patzf/DC-Motor-Board/img/rendering.png

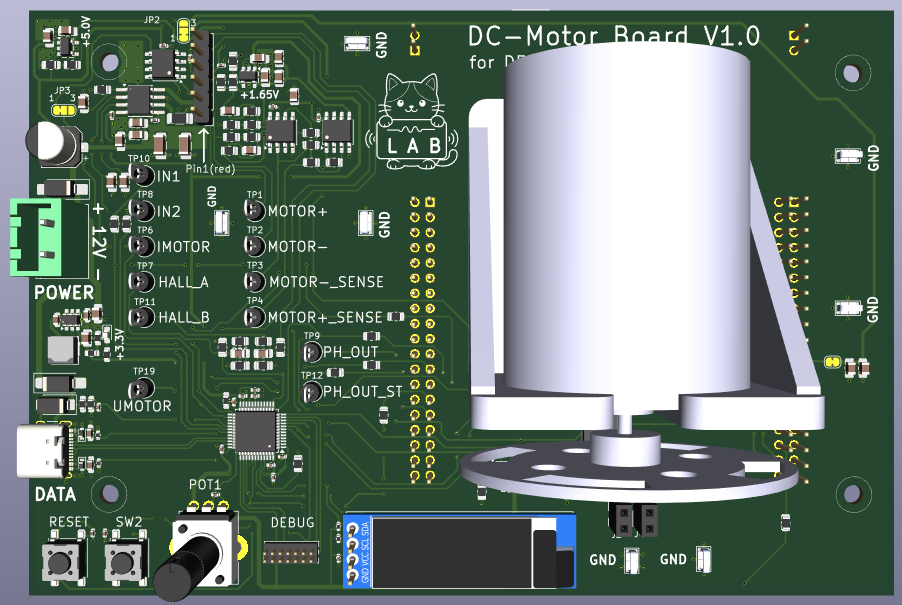
img/rendering.png
