patzf/DC-Motor-Board/fw/notes_streaming.txt

10kHz Abtastrate: Bei einem Signal: 16Bit = 2 Byte
wenn alle 10ms ein transfer zu PC: 10000*2Byte/(1000ms/10ms) = 200Byte/10ms - >8N1 -> 2kBit/10ms -> 200kBit/s 
-> ADC Buffer: doppelte Größe -> 400 Byte/ Kanal

Bei Spannung und Strom: 2 Signale zu je 16 Bit @ 10kHz: 320000 Bit/s Rohdaten ohne 16->12 "reduktion")
Für 8N1 über UART -> *1.25 weil 2 von 10 bit overhead -> 400000 Bit/s

For Standad UART:
USARTDIV = 170E6/(16*baudrate)
-> Baudrate: 460800

FOR LPUART
LPUARTDIV = 256*fck/Baudrate

For testing 1KhZ-> TIM4: prescaler (3)
170e6/((3+1)* 1e3) = 42500

ADC2_IN14: single ended rank 1: UMOTOR (diffamp output)

                         ┌─────────────────────────────┐
                         │          TIM4                │
                         │      Update Event            │
                         └──────────────┬──────────────┘
                                        │
                                        │ TRGO
                                        ▼
                         ┌─────────────────────────────┐
                         │           ADC2               │
                         │     External Trigger        │
                         │     ADC conversion          │
                         └──────────────┬──────────────┘
                                        │
                                        │ ADC result
                                        ▼
                         ┌─────────────────────────────┐
                         │        ADC2 DMA              │
                         │       Circular Mode          │
                         └──────────────┬──────────────┘
                                        │
                         ┌──────────────┴──────────────┐
                         │                             │
                         ▼                             ▼
                  Half-transfer                  Transfer-complete
                    interrupt                       interrupt
                         │                             │
                         ▼                             ▼
          HAL_ADC_ConvHalfCpltCallback()     HAL_ADC_ConvCpltCallback()
                         │                             │
                         │                             │
                         ▼                             ▼
                  ┌─────────────┐               ┌─────────────┐
                  │   HALF A    │               │   HALF B    │
                  │ ADC buffer  │               │ ADC buffer  │
                  └──────┬──────┘               └──────┬──────┘
                         │                             │
                         │                             │
                         ▼                             ▼
                  LPUART TX DMA                LPUART TX DMA
                         │                             │
                         └──────────────┬──────────────┘
                                        │
                                        ▼
                                  LPUART TX pin

adc_buffer[]
┌───────────────────────┬───────────────────────┐
│        HALF A         │        HALF B         │
│                       │                       │
│ ADC writes here       │ ADC writes here       │
│ then UART sends here  │ then UART sends here  │
└───────────────────────┴───────────────────────┘
          ↑                         ↑
          │                         │
     half callback             complete callback

ADC DMA:

        fill A             fill B             fill A
    ────────────────┬────────────────┬────────────────
                    │                │
                    ▼                ▼
                 HALF IRQ         COMPLETE IRQ
                    │                │
                    │                │
                    ▼                ▼
                UART sends A     UART sends B

yes. so we now produce 12 bit adc raw data of only one channel of the ADC with 10kHz sample rate and send every 10ms. i will paste you a zip with the pc side python code. please son´t throw away the code parts that we current do not use since we will use them later. just adapt the aquisition worker code and live graph for the current so it matches what we defined

please knock out the code that only simulated data for the curretnversion so that the plotting yould be tested
we only want to use real values from now on. still, keep the qidgets as is, even if we are now only receiving data for one plot (the current) at the moment

I'll specifically adapt:

Acquisition worker → read the STM32's raw uint16_t little-endian stream.
Current acquisition → 10 kHz, one ADC channel.
Block handling → 10 samples / 20 bytes per 10 ms.
Serial buffering → robustly handle arbitrary chunks returned by the VCP, rather than assuming each read() is exactly 20 bytes.
Live current graph → update at the appropriate rate using the received samples.
Preserve the existing infrastructure/code for the other quantities/channels and future functionality, even if currently unused.
Preserve your existing architecture and naming where practical rather than rewriting the application.

please tell me exactly (please analyse deeply, not just getting back to me after the first idea) why the following python visualizsation code that vizualizes DC motor current data (at the moment, only current data is receieved, no voltage) prints the received data fine, but as soon as the source is disconnected or stopd sending data, old ringbuffer data is plotted over and over again. please point out which part of the code does this and do all necessary modifications needed so that ebery data point is plotted only once, so no old data is plotted. the "liec" plot should not increase the time axis anymore or show delivered data when there is no new data to plot .

USB: CubeMX
Enable USB device
middleware->USB device
Class for FS IP: CDC
-> user code additions as documented in screenshot named usb_enum_wait_for.png 
to wait for device enumeration. if that is not ready before adc is ready, theusb_cdc_call throws busy since the data structure is not yet initialised
-> add code for LineCoding
