patzf/DC-Motor-Board/fw/non_eak_callback.png

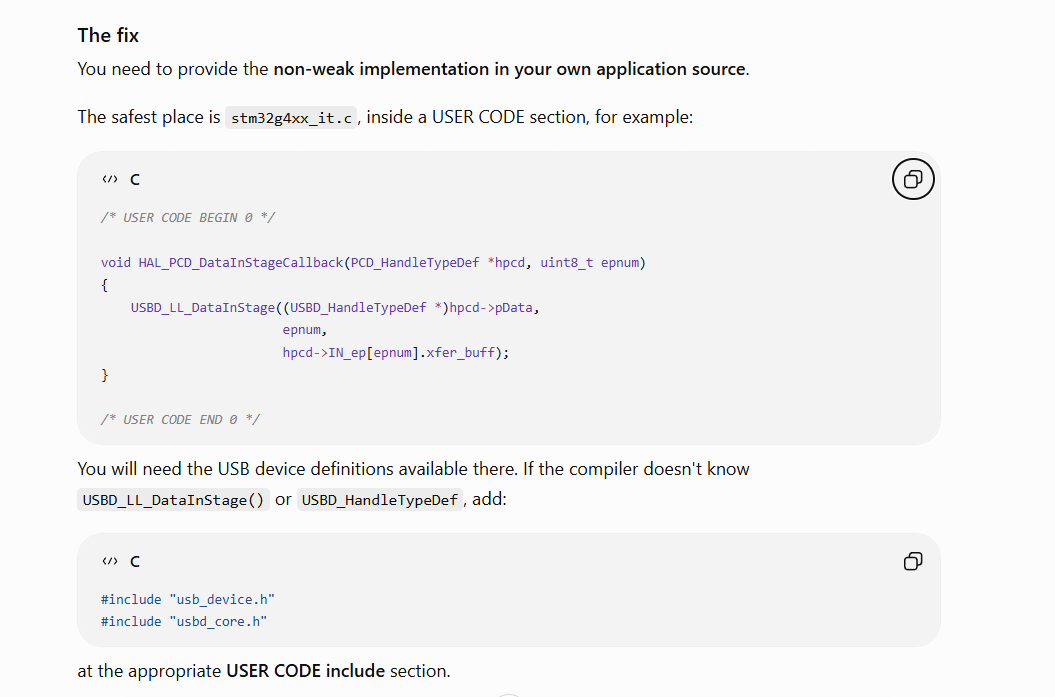
fw/non_eak_callback.png
