patzf/DC-Motor-Board/fw/Rigol_DS4014E_Captures/raw/rigol_raw_70k_20260911_002849_keine_Strombegrenzung.png

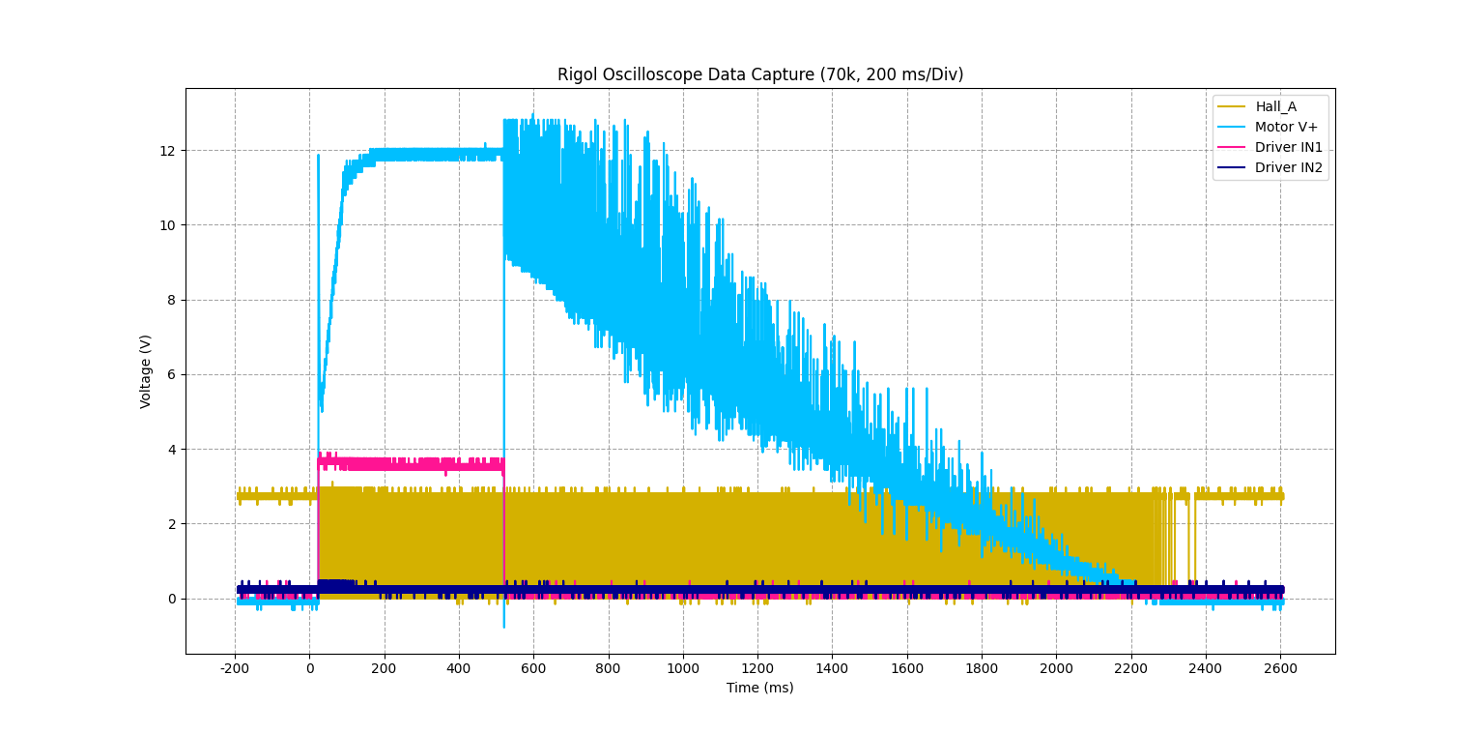
fw/Rigol_DS4014E_Captures/raw/rigol_raw_70k_20260911_002849_keine_Strombegrenzung.png
