patzf/DC-Motor-Board/fw/usb_enum_wait_for.png

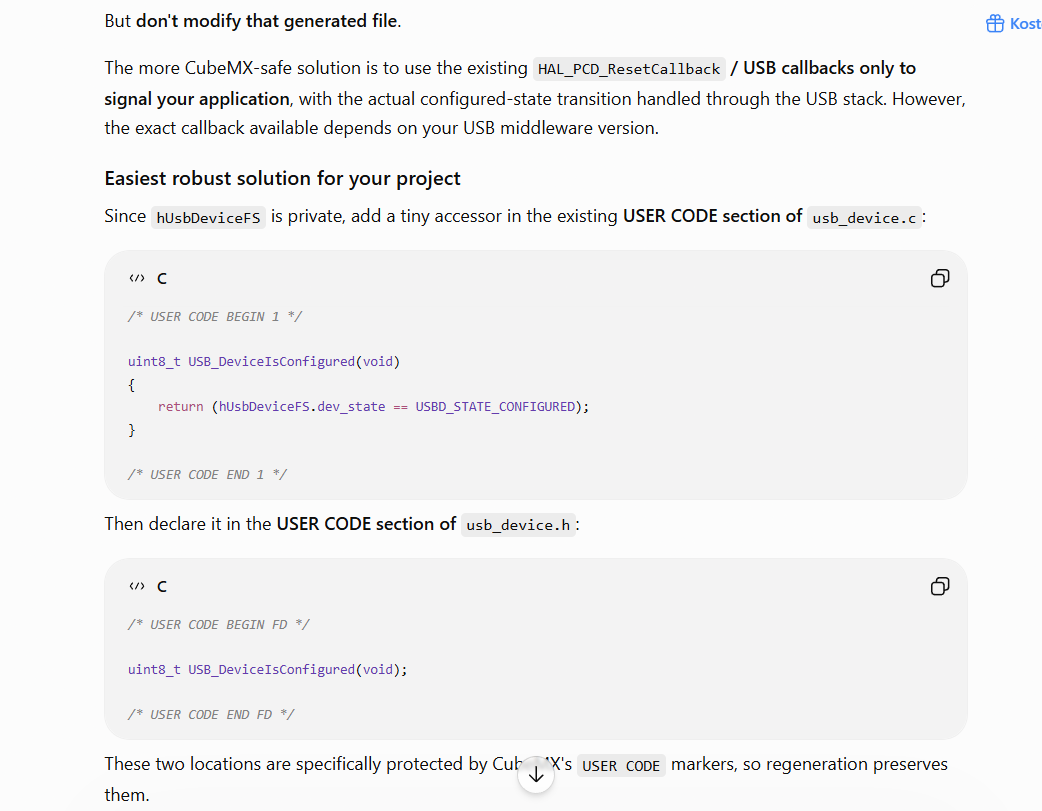
fw/usb_enum_wait_for.png
