patzf/DC-Motor-Board/img/bottom_rendering.png

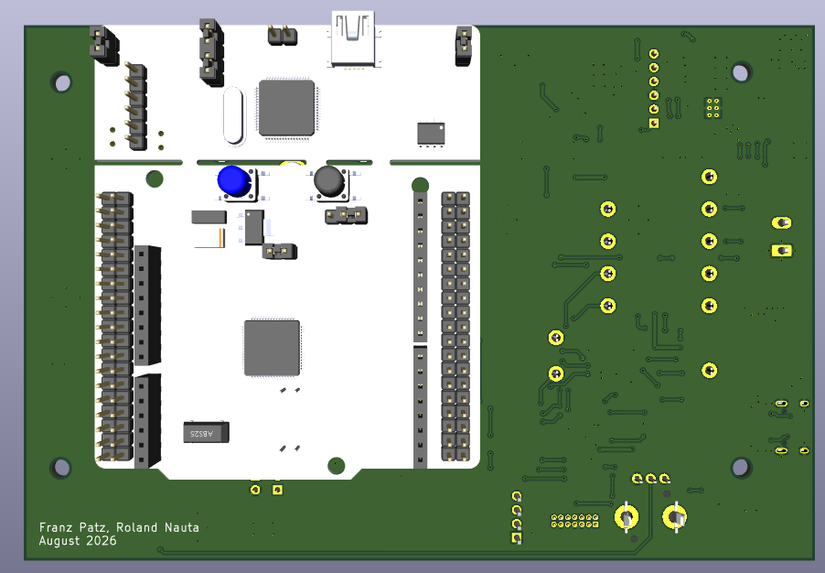
img/bottom_rendering.png
