patzf/DC-Motor-Board/hw/V1.1/NUCLEO-L432KC.step

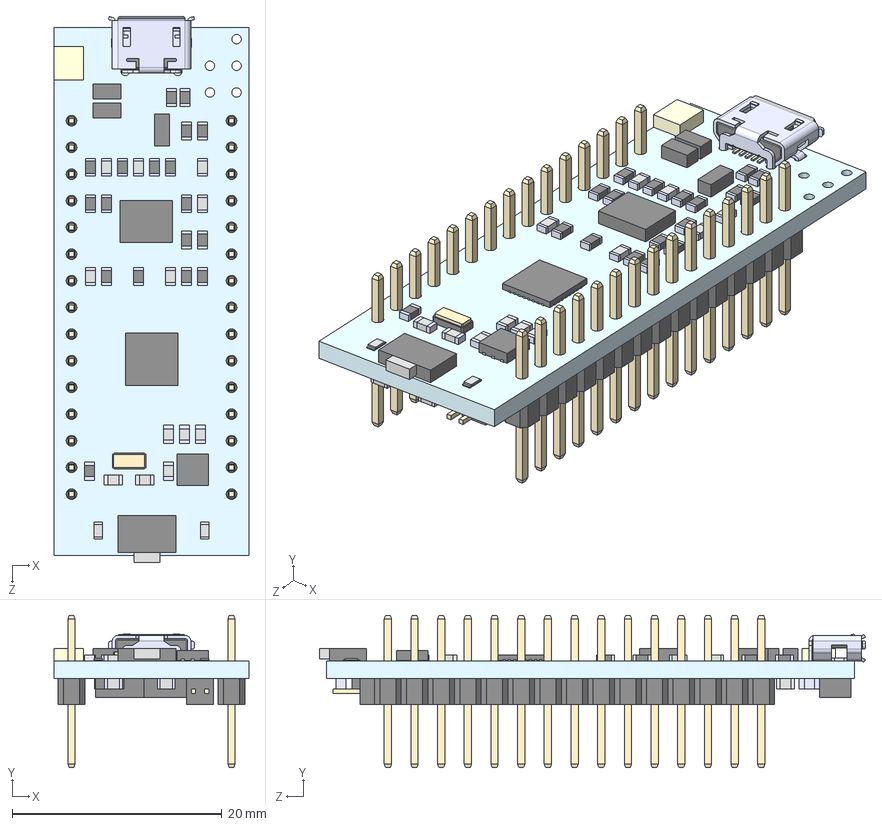
[picture p8: CAD file, 2026-09-05]
hw/V1.1/NUCLEO-L432KC.step
18.5 x 14.5 x 52.0 mm
mb1180c
qfn_STM32L412KBU6U
LD39050PU33R-Nucleo
STM32F103CBT6-nucleo
header x2
