patzf/DC-Motor-Board/motor/transmotec/Transmotec-Cad-770.stp

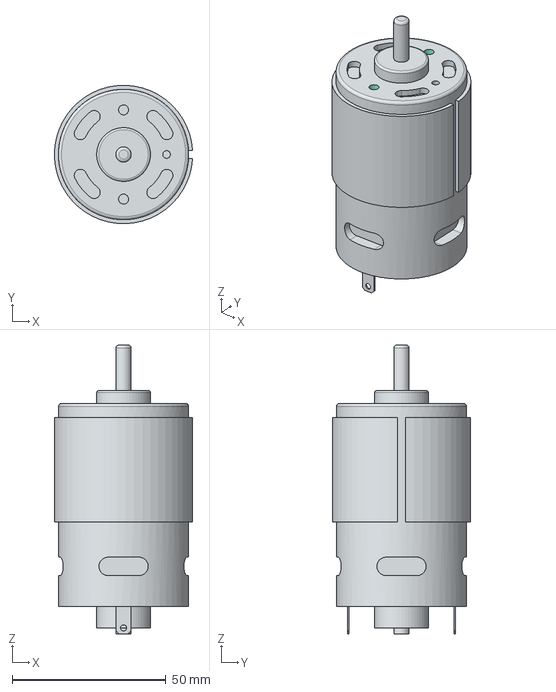
[picture p9: CAD file, 2026-07-14]
motor/transmotec/Transmotec-Cad-770.stp
45.0 x 45.0 x 94.0 mm
