patzf/DC-Motor-Board/hw/V1.1/Motorhalterung.FCStd

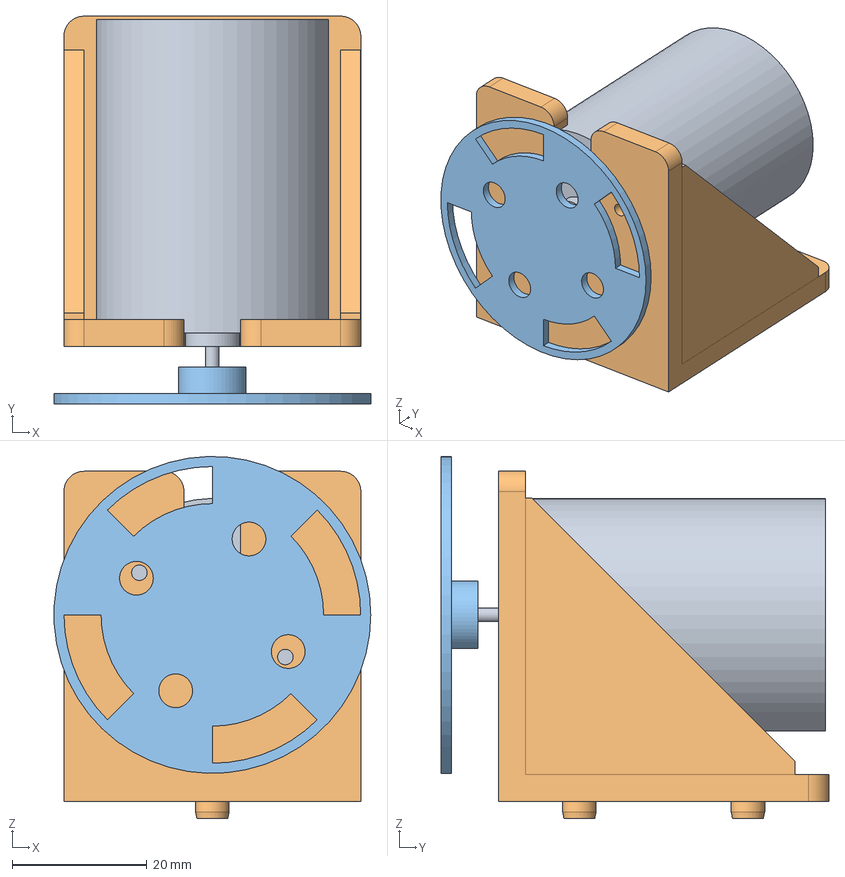
[picture p10: CAD file, 2026-08-11]
hw/V1.1/Motorhalterung.FCStd
47.0 x 57.5 x 53.7 mm
Motor
Halterung
Lochscheibe
