patzf/DC-Motor-Board/(list of files, cad)

Other CAD files:
hw/V1.1/Motorhalterung_comp_v1.step
