patzf/DC-Motor-Board/fw/Nucleo_G431KB_Captures/stepRsp_Duty0-100_12VDC.png

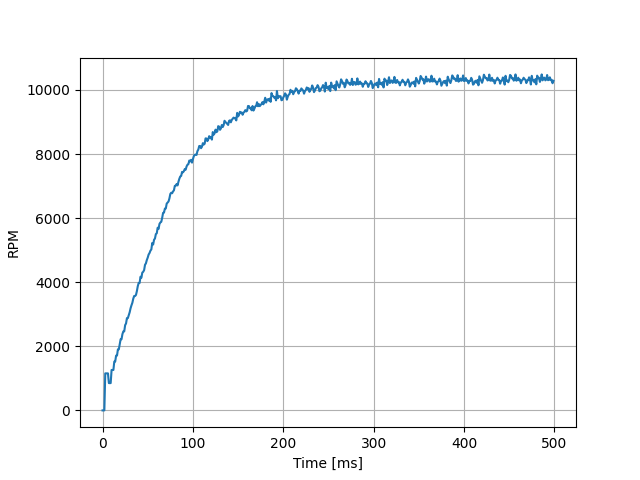
fw/Nucleo_G431KB_Captures/stepRsp_Duty0-100_12VDC.png
