patzf/DC-Motor-Board/dcMotor.pdf

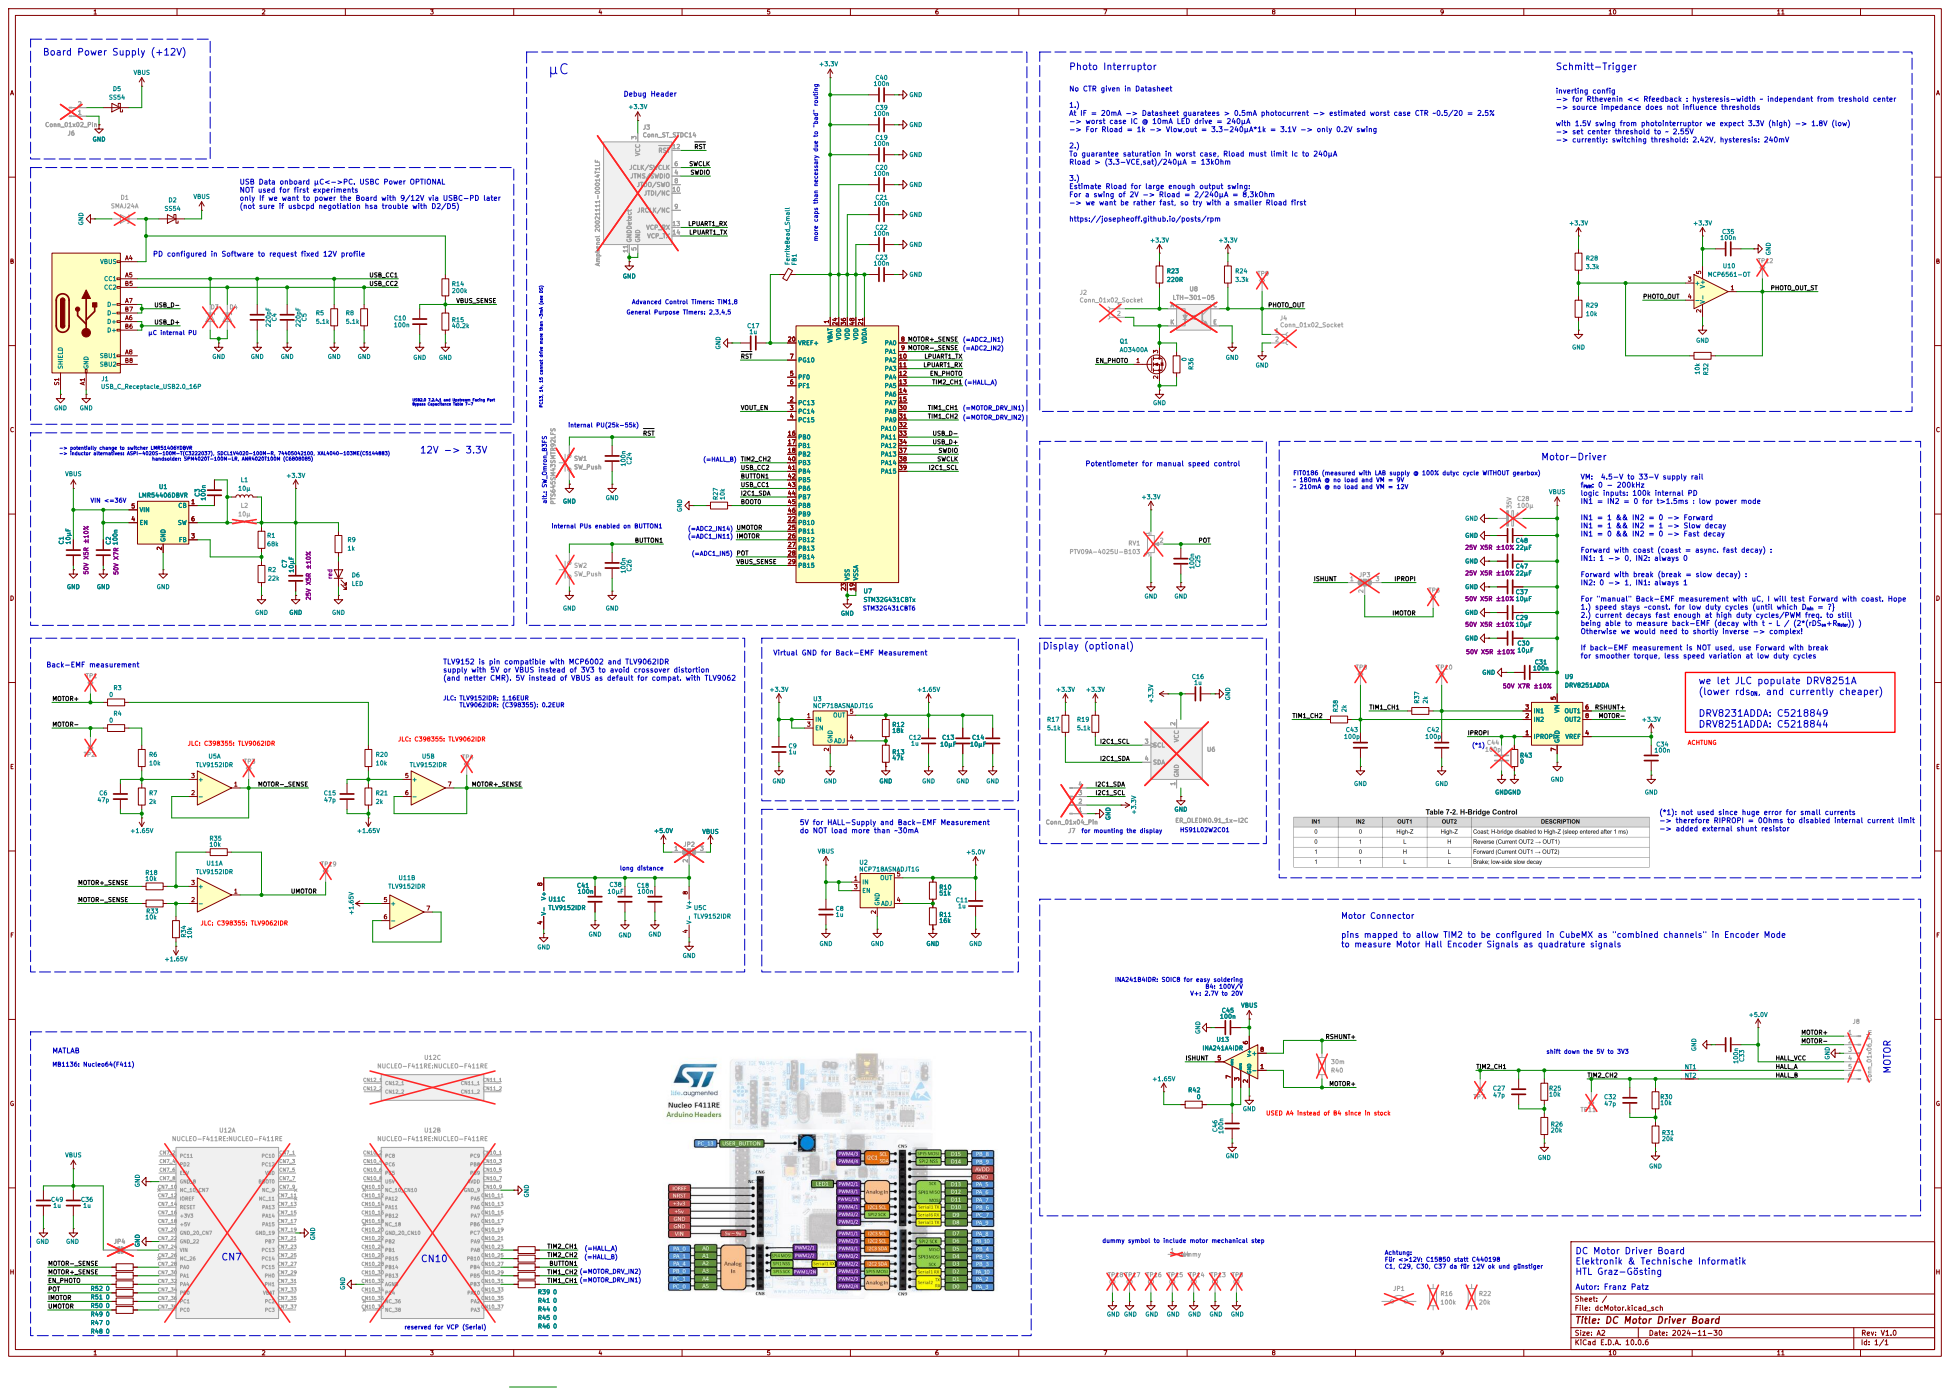
[picture p14: page 1]

No CTR given in Datasheet

inverting config -> for Rthevenin << Rfeedback : hysteresis-width ~ independant from treshold center -> source impedance does not influence thresholds

At IF = 20mA -> Datasheet guaratees > 0.5mA photocurrent -> estimated worst case CTR ~0.5/20 = 2.5% -> worst case IC @ 10mA LED drive = 240µA -> For Rload = 1k -> Vlow,out = 3.3-240µA*1k = 3.1V -> only 0.2V swing

with 1.5V swing from photointerruptor we expect 3.3V (high) -> 1.8V (low) -> set center threshold to ~ 2.55V -> currently: switching threshold: 2.42V, hysteresis: 240mV

To guarantee saturation in worst case, Rload must limit Ic to 240µA
Rload > (3.3-VCE,sat)/240µA = 13kOhm

USB Data onboard µC<->PC. USBC Power OPTIONAL
NOT used for first experiments
only If we want to power the Board with 9/12V via USBC-PD later

Estimate Rload for large enough output swing:
For a swing of 2V -> Rload = 2/240µA = 8,3kOhm
-> we want be rather fast, so try with a smaller Rload first

(not sure if usbcpd negotiation hsa trouble with D2/D5) VIN <=36V
SMAJ24A GND

https://josepheoff.github.io/posts/rpm

PD configured in Software to request fixed 12V profile
5.1k GND

internal PUs enabled on BUTTON1 alt.: SW_Omron_B3FS

-> potentially change to switcher LMR51406YDBVR -> inductor alternatives: ASPI-4020S-100M-T(C3222037), SDCL1V4020-100M-R, 74405042100, XAL4040-103ME(C5144883) handsolder: SPM4020T-100M-LR, ANR4020T100M (C6808085)

VM: 4.5-V to 33-V supply rail
fPWM: 0 - 200kHz
logic inputs: 100k internal PD
IN1 = IN2 = 0 for t>1.5ms : low power mode

~ 210mA @ no load and VM = 12V

Forward with coast (coast = async. fast decay) :
IN1: 1 -> 0, IN2: always 0

Forward with break (break = slow decay) :
IN2: 0 -> 1, IN1: always 1

For "manual" Back-EMF measurement with uC, I will test Forward with coast. Hope
1.) speed stays ~const. for low duty cycles (until which Dmin = ?} 2.) current decays fast enough at high duty cycles/PWM freq. to still

being able to measure back-EMF (decay with t ~ L / (2*(rDSon+RMotor)) )
Otherwise we would need to shortly inverse -> complex!

If back-EMF measurement is NOT used, use Forward with break
for smoother torque, less speed variation at low duty cycles

Virtual GND for Back-EMF Measurement

TLV9152 is pin compatible with MCP6002 and TLV9062IDR
supply with 5V or VBUS instead of 3V3 to avoid crossover distortion
(and netter CMR). 5V instead of VBUS as default for compat. with TLV9062

ACHTUNG we let JLC populate DRV8251A
(lower rdsON, and currently cheaper)

(*1): not used since huge error for small currents -> therefore RIPROPI = 0Ohms to disabled internal current limit -> added external shunt resistor

5V for HALL-Supply and Back-EMF Measurement
do NOT load more than ~30mA

pins mapped to allow TIM2 to be configured in CubeMX as "combined channels" in Encoder Mode
to measure Motor Hall Encoder Signals as quadrature signals

shift down the 5V to 3V3

USED A4 instead of B4 since in stock

dummy symbol to include motor mechanical step

Achtung: Für <>12V: C15850 statt C440198 C1, C29, C30, C37 da für 12V ok und günstiger

DC Motor Driver Board
Elektronik & Technische Informatik
HTL Graz-Gösting

Autor: Franz Patz
Sheet: /
File: dcMotor.kicad_sch
Title: DC Motor Driver Board

reserved for VCP (Serial)

Size: A2 | Rev: V1.0
KiCad E.D.A. 10.0.6 | Id: 1/1
