patzf/DC-Motor-Board/sim/diffamp_voltages.asc

C1: cap; 47p
C2: cap; 47p
R1: res; 10k
R2: res; 2k
R3: res; 1G
R4: res; 10k
R5: res; 2k
U1: opamp2; MCP6001
U2: opamp2; MCP6001
V1: voltage; SINE(0 12 1k)
V2: voltage; 3.3
V3: voltage; 1.65
V4: voltage; 0
Named nets: 0, 3V3, 1V65, out1, out2, mid1, mid2
.tran 2m
.inc MCP6001-bordodynov.txt
