patzf/DC-Motor-Board/sim/vdiv_w_cap_loded_pulse_vdrop.asc

C1: cap; 100µ
R1: res; 1k
R2: res; 1k
R3: res; 470
R4: res; 100k
V1: voltage; 3.3
V2: voltage; PULSE(1.65 0 10m 100e-9 100e-9 10m 20m)
Named nets: 0, mid
.tran 30m
.inc MCP6001-bordodynov.txt
