patzf/DC-Motor-Board/hw/V1.1/dcMotor.kicad_pcb

## KiCad design hw/V1.1/dcMotor.kicad_pcb (2026-09-22)

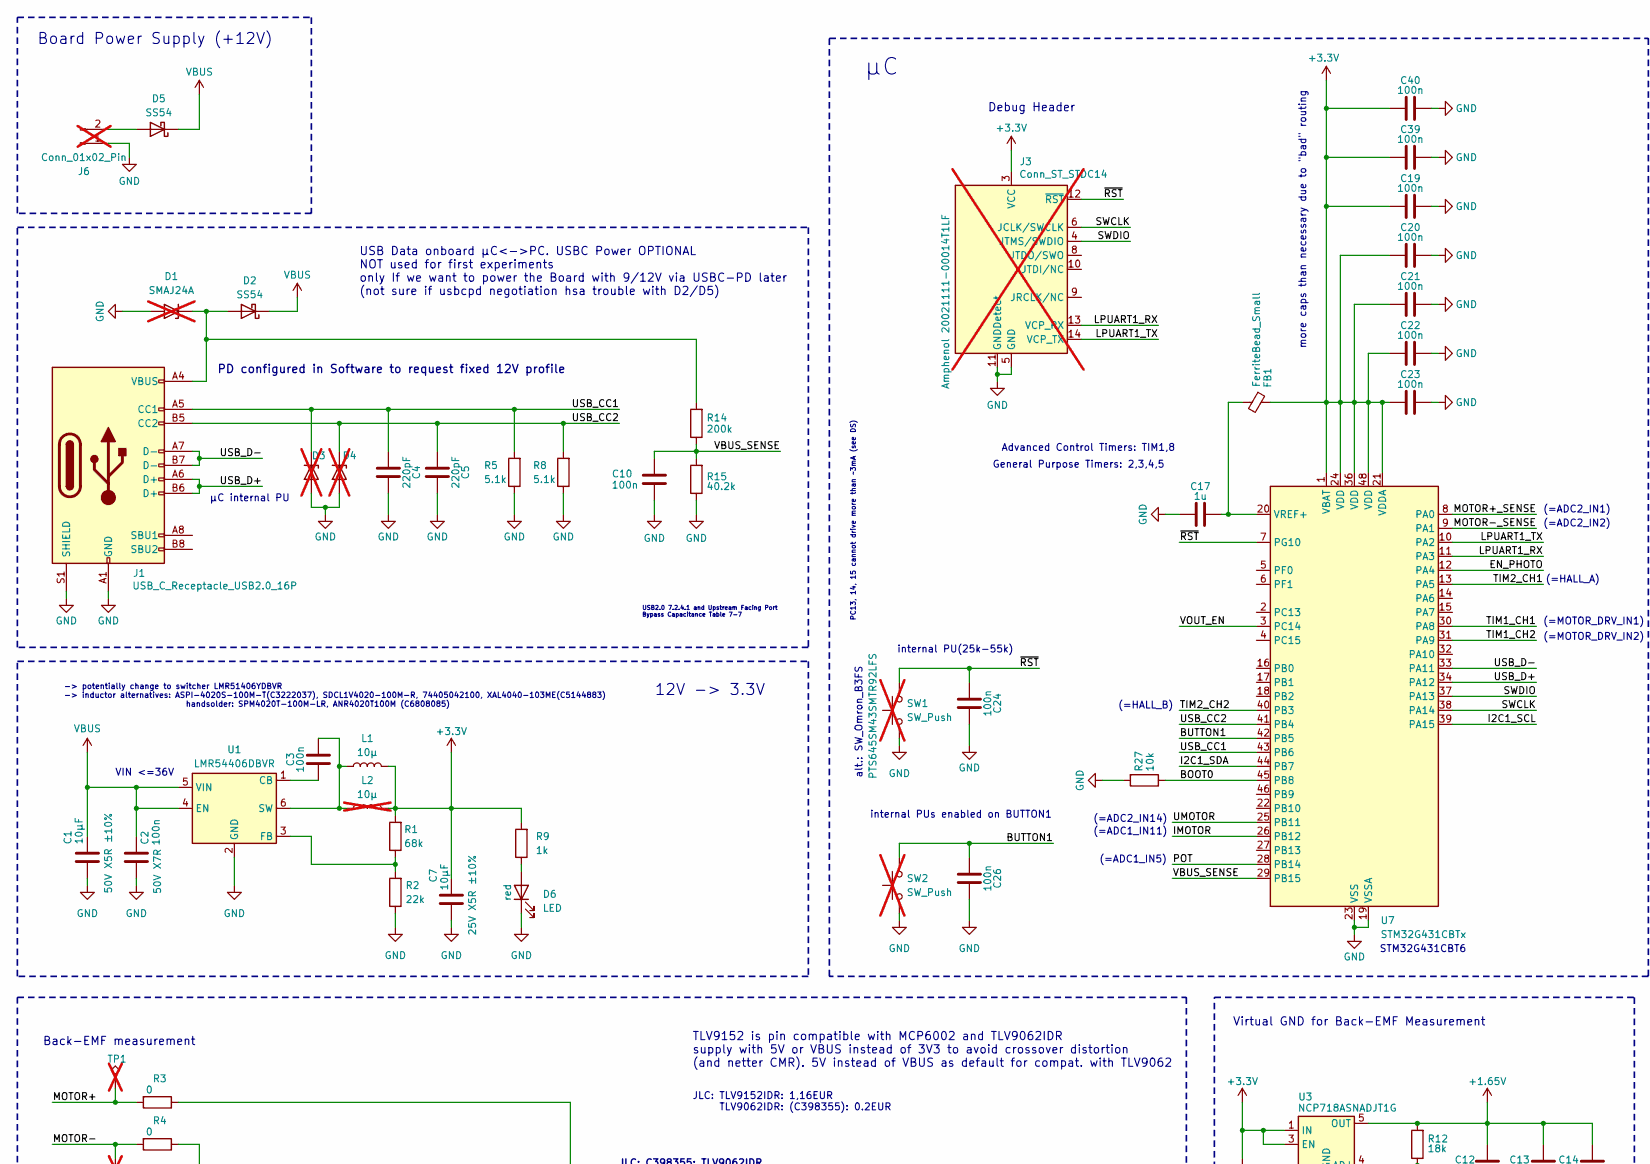
[picture p15: schematic dcMotor.kicad_sch, DC Motor Driver Board, part in row 1, column 1]

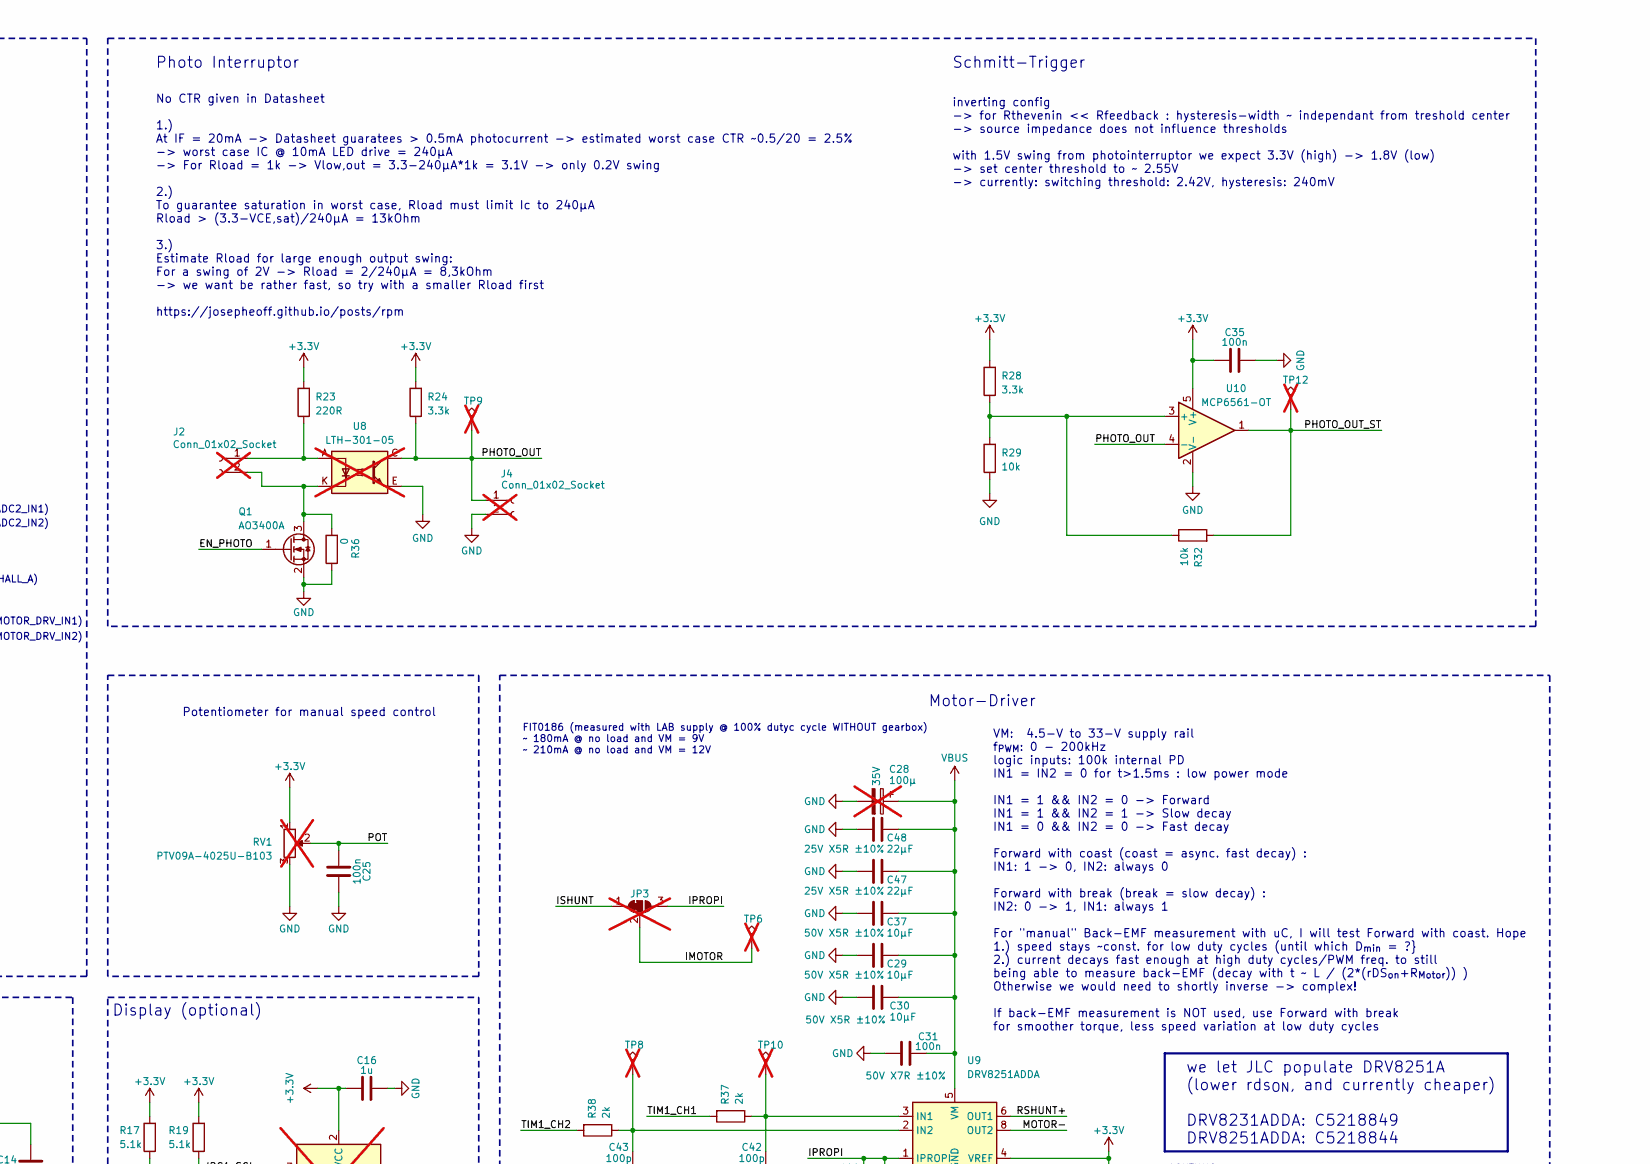
[picture p16: schematic dcMotor.kicad_sch, DC Motor Driver Board, part in row 1, column 2]

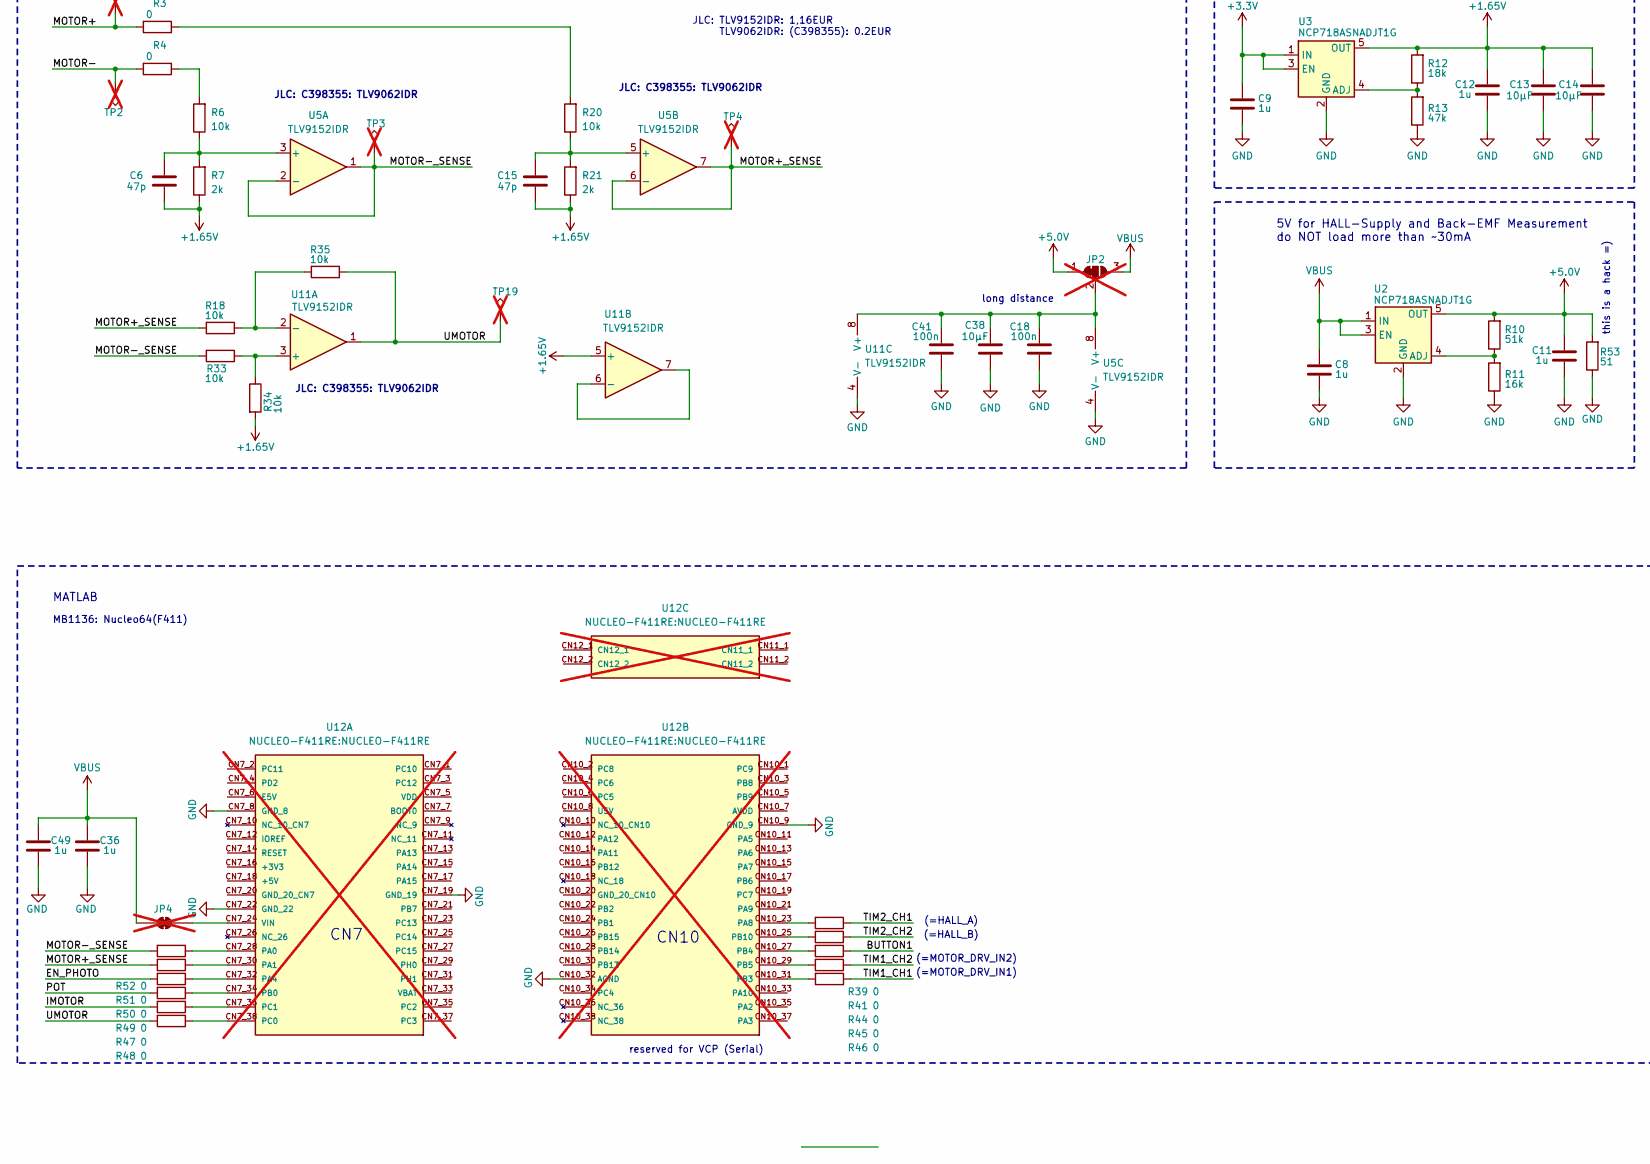
[picture p17: schematic dcMotor.kicad_sch, DC Motor Driver Board, part in row 2, column 1]

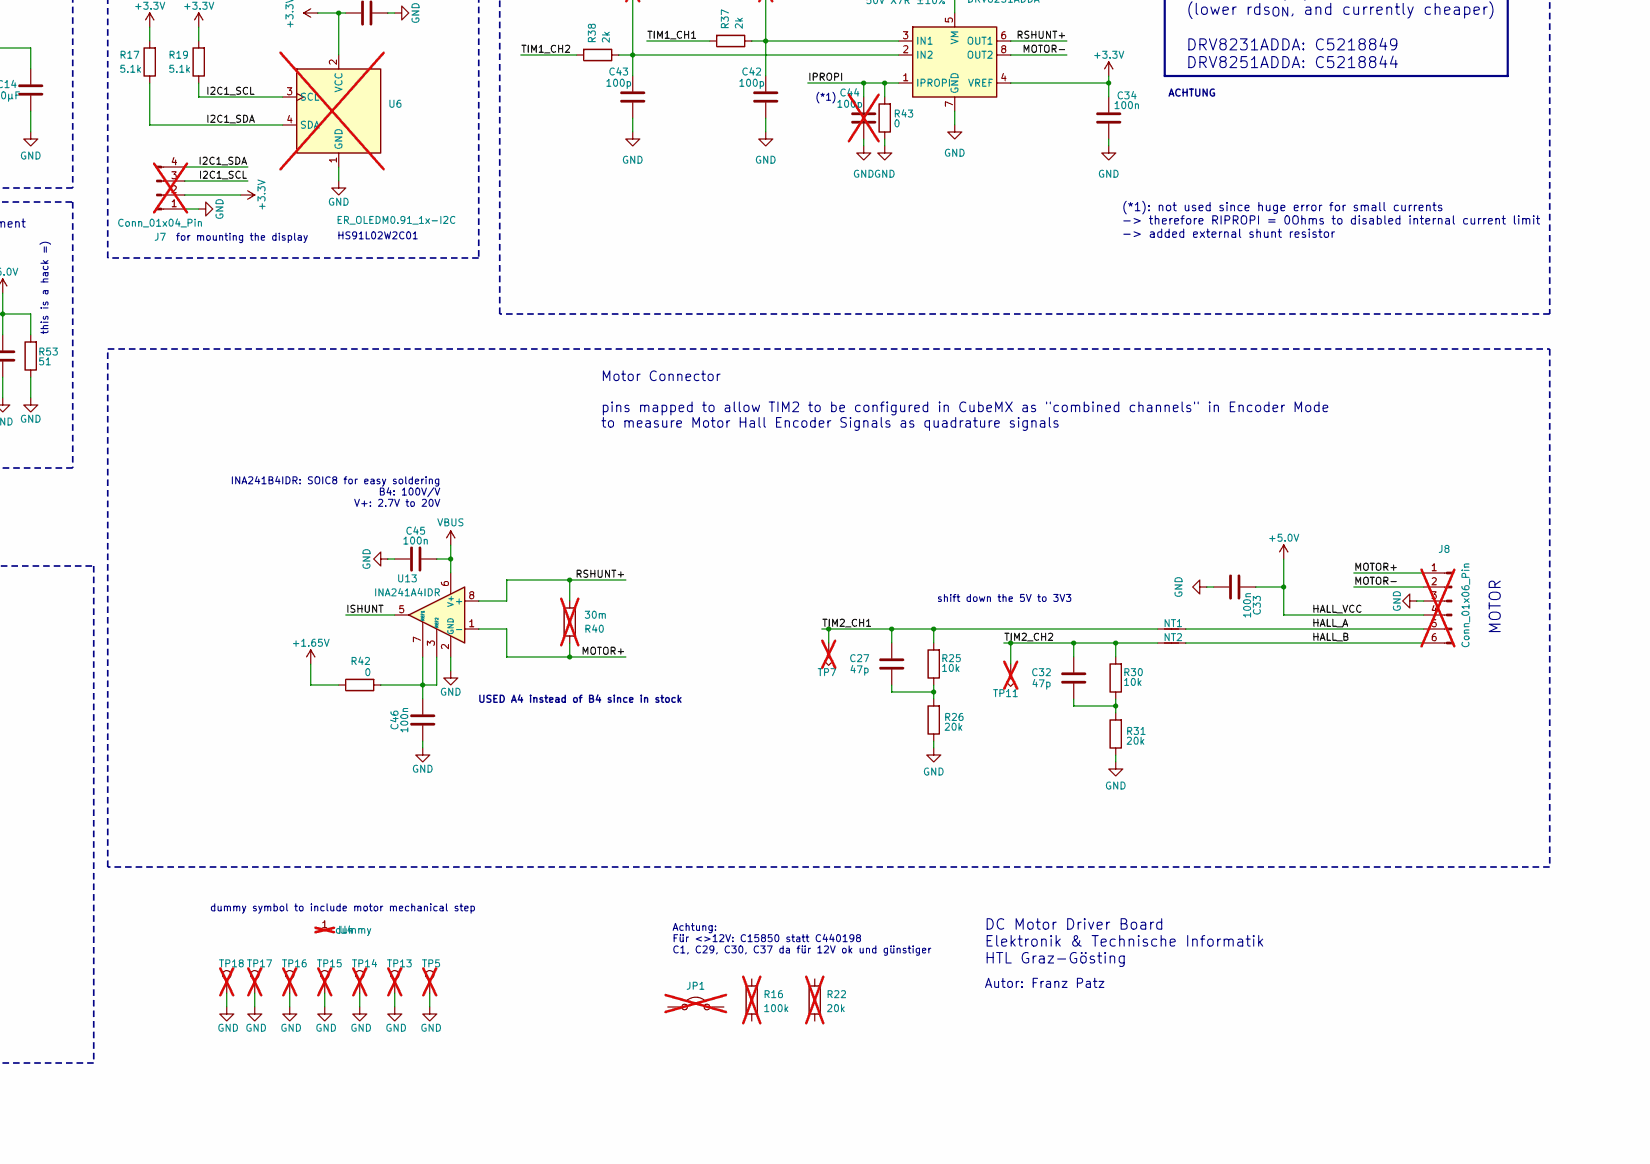
[picture p18: schematic dcMotor.kicad_sch, DC Motor Driver Board, part in row 2, column 2]

Parts:
C1, C29, C30, C37: 10µF; C_0805_2012Metric_Pad1.18x1.45mm_HandSolder; LCSC Part # C15850
C2, C3: 100n; C_0603_1608Metric; LCSC Part # C14663
C4, C5: 220pF; C_0603_1608Metric_Pad1.08x0.95mm_HandSolder; LCSC Part # C1603
C6, C15, C27, C32: 47p; C_0805_2012Metric_Pad1.18x1.45mm_HandSolder; LCSC Part # C14857
C7, C13, C14, C38: 10µF; C_0805_2012Metric; LCSC Part # C15850
C8, C9, C11, C12, C36, C49: 1u; C_0805_2012Metric_Pad1.18x1.45mm_HandSolder; LCSC Part # C28323
C10, C18, C19, C20, C21, C22, C23, C24, C25, C26, C31, C33, C34, C35, C39, C40, C41, C45, C46: 100n; C_0402_1005Metric; LCSC Part # C307331
C16, C17: 1u; C_0402_1005Metric; LCSC Part # C52923
C28: 100µ; CP_Elec_6.3x7.7; LCSC Part # C5145169; not fitted
C42, C43: 100p; C_0805_2012Metric_Pad1.18x1.45mm_HandSolder; LCSC Part # C1790
C44: 100p; C_0805_2012Metric_Pad1.18x1.45mm_HandSolder; LCSC Part # C1790; not fitted
C47, C48: 22µF; C_1206_3216Metric_Pad1.33x1.80mm_HandSolder; LCSC Part # C12891
D1: SMAJ24A; D_SMA; LCSC Part # C132947; not fitted
D2, D5: SS54; D_SMA_Handsoldering; LCSC Part # C22452
D3, D4: ESD5Zxx; D_SOD-523; LCSC Part # C5199848; not fitted
D6: LED; LED_0603_1608Metric_Pad1.05x0.95mm_HandSolder; LCSC Part # C2286
FB1: FerriteBead_Small; R_0603_1608Metric_Pad0.98x0.95mm_HandSolder; LCSC Part # C1002
J1: USB_C_Receptacle_USB2.0_16P; USB_C_Receptacle_HCTL_HC-TYPE-C-16P-01A; LCSC Part # C2894897
J2, J4: Conn_01x02_Socket; PinSocket_1x02_P2.54mm_Vertical; not fitted
J3: Conn_ST_STDC14; PinHeader_2x07_P1.27mm_Vertical; LCSC Part # C3325730; not fitted
J6: Conn_01x02_Pin; PhoenixContact_MSTBVA_2,5_2-G-5,08_1x02_P5.08mm_Vertical; LCSC Part # C480503; not fitted
J7: Conn_01x04_Pin; PinHeader_1x04_P2.54mm_Vertical; LCSC Part # C7430360; not fitted
J8: Conn_01x06_Pin; PinHeader_1x06_P2.54mm_Vertical; not fitted
JP1: Jumper_2_Open; PinHeader_1x02_P2.54mm_Vertical; LCSC Part # C492401; not fitted
JP2, JP3: SolderJumper_3_Bridged12; SolderJumper-3_P1.3mm_Bridged12_RoundedPad1.0x1.5mm_NumberL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; not fitted
JP4: SolderJumper_2_Bridged; SolderJumper-2_P1.3mm_Bridged_RoundedPad1.0x1.5mm; not fitted
L1: 10µ; IND_SPM4020T-100M-LR; LCSC Part # C307805
L2: 10µ; L_Abracon_ASPIAIG-F4020; LCSC Part # C3222037; not fitted
NT1, NT2: NetTie_2; R_0805_2012Metric_Pad1.20x1.40mm_HandSolder; LCSC Part # C17477
Q1: AO3400A; SOT-23; LCSC Part # C20917
R1: 68k; R_0603_1608Metric; LCSC Part # C23231
R2: 22k; R_0603_1608Metric; LCSC Part # C31850
R3, R4, R36, R39, R41, R42, R43, R44, R45, R46, R47, R48, R49, R50, R51, R52: 0; R_0805_2012Metric; LCSC Part # C17477
R5, R8, R17, R19: 5.1k; R_0402_1005Metric; LCSC Part # C25905
R6, R18, R20, R25, R27, R29, R30, R32, R33, R34, R35: 10k; R_0805_2012Metric; LCSC Part # C17414
R7, R21, R37, R38: 2k; R_0805_2012Metric; LCSC Part # C17604
R9: 1k; R_0603_1608Metric; LCSC Part # C21190
R10: 51k; R_0805_2012Metric; LCSC Part # C17737
R11: 16k; R_0805_2012Metric_Pad1.20x1.40mm_HandSolder; LCSC Part # C17490
R12: 18k; R_0805_2012Metric; LCSC Part # C17506
R13: 47k; R_0805_2012Metric_Pad1.20x1.40mm_HandSolder; LCSC Part # C17713
R14: 200k; R_0603_1608Metric_Pad0.98x0.95mm_HandSolder; LCSC Part # C25811
R15: 40.2k; R_0603_1608Metric_Pad0.98x0.95mm_HandSolder; LCSC Part # C12447
R16: 100k; R_0805_2012Metric; LCSC Part # C149504; not fitted
R22: 20k; R_0805_2012Metric; LCSC Part # C4328; not fitted
R23: 220R; R_0805_2012Metric; LCSC Part # C17557
R24, R28: 3.3k; R_0805_2012Metric; LCSC Part # C26010
R26, R31: 20k; R_0805_2012Metric_Pad1.20x1.40mm_HandSolder; LCSC Part # C4328
R40: 30m; R_1206_3216Metric_Pad1.30x1.75mm_HandSolder; not fitted
R53: 51; R_0805_2012Metric; LCSC Part # C17738
RV1: PTV09A-4025U-B103; Potentiometer_Bourns_PTV09A-1_Single_Vertical; not fitted
SW1, SW2: SW_Push; SW_SPST_PTS645Sx43SMTR92; LCSC Part # C221880; not fitted
TP1, TP2, TP3, TP4, TP6, TP7, TP8, TP9, TP10, TP11, TP12, TP19: TP_Keystone_5010; TP_Keystone_5010-5014_Multipurpose; LCSC Part # C2906765; not fitted
TP5, TP13, TP14, TP15, TP16, TP17, TP18: TestPoint_Keystone_5019; TestPoint_Keystone_5019_Miniature; LCSC Part # C238131; not fitted
U1: LMR54406DBVR; SOT-23-6; LCSC Part # C5219316
U2, U3: NCP718ASNADJT1G; SOT-23-5; LCSC Part # C440035
U4: na; not fitted
U5, U11: TLV9152IDR; SOIC-8_3.9x4.9mm_P1.27mm; LCSC Part # C398355
U6: ER_OLEDM0.91_1x-I2C; LCSC Part # C5248081; not fitted
U7: STM32G431CBTx; LQFP-48_7x7mm_P0.5mm; LCSC Part # C529355
U8: LTH-301-05; LCSC Part # C575483; not fitted
U9: DRV8251ADDA; Texas_HTSOP-8-1EP_3.9x4.9mm_P1.27mm_EP2.95x4.9mm_Mask2.4x3.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; LCSC Part # C5218844
U10: MCP6561-OT; SOT-23-5; LCSC Part # C117501
U12: NUCLEO-F411RE:NUCLEO-F411RE; BOARD_NUCLEO-F411RE; not fitted
U13: INA241A4IDR; SOIC-8_3.9x4.9mm_P1.27mm; LCSC Part # C22427873

Connections:
+1.65V: C6.2, C12.2, C13.2, C14.2, C15.2, R7.1, R12.2, R21.1, R34.2, R42.1, U3.5 (OUT), U11.5 (+)
+3.3V: C7.2, C9.2, C16.2, C19.2, C20.2, C21.2, C22.2, C23.2, C34.1, C35.2, C39.2, C40.2, FB1.1, J3.3 (VCC), J7.2, L1.2, L2.2, R1.2, R9.2, R17.2, R19.2, R23.2, R24.2, R28.2, RV1.1, U3.1 (IN), U3.3 (EN), U6.2 (VCC), U7.1 (VBAT), U7.21 (VDDA), U7.24 (VDD), U7.36 (VDD), U7.48 (VDD), U9.4 (VREF), U10.5 (V+)
+5.0V: C11.2, C33.1, J8.4, JP2.1 (A), R10.2, R53.2, U2.5 (OUT)
/BOOT0: R27.1, U7.45 (PB8)
/BUTTON1: C26.2, R44.1, SW2.2, U7.42 (PB5)
/EN_PHOTO: Q1.1 (G), R50.2, U7.12 (PA4)
/HALL_A: J8.5, NT1.2
/HALL_B: J8.6, NT2.2
/I2C1_SCL: J7.3, R19.1, U6.3 (SCL), U7.39 (PA15)
/I2C1_SDA: J7.4, R17.1, U6.4 (SDA), U7.44 (PB7)
/IMOTOR: JP3.2 (C), R47.2, TP6.1 (1_1), U7.26 (PB12)
/IPROPI: C44.1, JP3.3 (B), R43.2, U9.1 (IPROPI)
/ISHUNT: JP3.1 (A), U13.5
/LPUART1_RX: J3.13 (VCP_RX), U7.11 (PA3)
/LPUART1_TX: J3.14 (VCP_TX), U7.10 (PA2)
/MOTOR+: J8.1, R3.2, R40.2, TP1.1 (1_1), U13.1 (-)
/MOTOR+_SENSE: R18.2, R51.2, TP4.1 (1_1), U5.6 (-), U5.7, U7.8 (PA0)
/MOTOR-: J8.2, R4.2, TP2.1 (1_1), U9.8 (OUT2)
/MOTOR-_SENSE: R33.2, R52.2, TP3.1 (1_1), U5.1, U5.2 (-), U7.9 (PA1)
/PHOTO_OUT: J4.1, R24.1, TP9.1 (1_1), U8.C, U10.4 (-)
/PHOTO_OUT_ST: R32.2, TP12.1 (1_1), U10.1
/POT: C25.2, R49.2, RV1.2, U7.28 (PB14)
/RSHUNT+: R40.1, U9.6 (OUT1), U13.8 (+)
/SWCLK: J3.6 (JCLK/SWCLK), U7.38 (PA14)
/SWDIO: J3.4 (JTMS/SWDIO), U7.37 (PA13)
/TIM1_CH1: R37.2, R46.1, U7.30 (PA8)
/TIM1_CH2: R38.2, R45.1, U7.31 (PA9)
/TIM2_CH1: C27.1, NT1.1, R25.2, R39.1, TP7.1 (1_1), U7.13 (PA5)
/TIM2_CH2: C32.1, NT2.1, R30.2, R41.1, TP11.1 (1_1), U7.40 (PB3)
/UMOTOR: R35.1, R48.2, TP19.1 (1_1), U7.25 (PB11), U11.1
/USB_CC1: C4.2, D3.1 (K), J1.A5 (CC1), R5.2, U7.43 (PB6)
/USB_CC2: C5.2, D4.1 (K), J1.B5 (CC2), R8.2, U7.41 (PB4)
/USB_D+: J1.A6 (D+), J1.B6 (D+), U7.34 (PA12)
/USB_D-: J1.A7 (D-), J1.B7 (D-), U7.33 (PA11)
/VBUS_SENSE: C10.1, R14.1, R15.2, U7.29 (PB15)
/VOUT_EN: U7.3 (PC14)
/~RST: C24.2, J3.12 (~RST), SW1.2, U7.7 (PG10)
GND: C1.2, C2.1, C4.1, C5.1, C7.1, C8.1, C9.1, C10.2, C11.1, C12.1, C13.1, C14.1, C16.1, C17.2, C18.1, C19.1, C20.1, C21.1, C22.1, C23.1, C24.1, C25.1, C26.1, C28.2, C29.2, C30.2, C31.2, C33.2, C34.2, C35.1, C36.1, C37.2, C38.1, C39.1, C40.1, C41.1, C42.2, C43.2, C44.2, C45.1, C46.1, C47.2, C48.2, C49.1, D1.2 (A2), D3.2 (A), D4.2 (A), D6.1 (K), J1.A1 (GND), J1.A12 (GND), J1.B1 (GND), J1.B12 (GND), J1.S1 (SHIELD), J3.5 (GND), J3.7 (GND), J3.11 (GNDDetect), J4.2, J6.1, J7.1, J8.3, Q1.2 (S), R2.1, R5.1, R8.1, R11.1, R13.1, R15.1, R26.1, R27.2, R29.1, R31.1, R36.1, R43.1, R53.1, RV1.3, SW1.1, SW2.1, TP5.1 (1_1), TP13.1 (1_1), TP14.1 (1_1), TP15.1 (1_1), TP16.1 (1_1), TP17.1 (1_1), TP18.1 (1_1), U1.2 (GND), U2.2 (GND), U3.2 (GND), U5.4 (V-), U6.1 (GND), U7.19 (VSSA), U7.23 (VSS), U7.35 (VSS), U7.47 (VSS), U8.E, U9.7 (GND), U9.9 (GND), U10.2 (V-), U11.4 (V-), U12.CN7_8 (GND_8), U12.CN7_19 (GND_19), U12.CN7_22 (GND_22), U12.CN10_9 (GND_9), U12.CN10_32 (AGND), U13.2 (GND), U13.4 (GND)
unnamed: C27.2, R25.1, R26.2
unnamed: C32.2, R30.1, R31.2
unnamed: D1.1 (A1), D2.2 (A), J1.A4 (VBUS), J1.A9 (VBUS), J1.B4 (VBUS), J1.B9 (VBUS), R14.2
unnamed: D5.2 (A), J6.2
unnamed: D6.2 (A), R9.1
unnamed: J2.1, R23.1, U8.A
unnamed: J2.2, Q1.3 (D), R36.2, U8.K
unnamed: C18.2, C38.2, C41.2, JP2.2 (C), U5.8 (V+), U11.8 (V+)
unnamed: JP4.2 (B), U12.CN7_24 (VIN)
unnamed: R4.1, R6.2
unnamed: R3.1, R20.2
unnamed: C3.2, U1.1 (CB)
unnamed: R1.1, R2.2, U1.3 (FB)
unnamed: C3.1, L1.1, L2.1, U1.6 (SW)
unnamed: R10.1, R11.2, U2.4 (ADJ)
unnamed: R12.1, R13.2, U3.4 (ADJ)
unnamed: C6.1, R6.1, R7.2, U5.3 (+)
unnamed: C15.1, R20.1, R21.2, U5.5 (+)
unnamed: C17.1, FB1.2, U7.20 (VREF+)
unnamed: C42.1, R37.1, TP10.1 (1_1), U9.3 (IN1)
unnamed: C43.1, R38.1, TP8.1 (1_1), U9.2 (IN2)
unnamed: R28.1, R29.2, R32.1, U10.3 (+)
unnamed: R33.1, R34.1, U11.3 (+)
unnamed: R18.1, R35.2, U11.2 (-)
unnamed: U11.6 (-), U11.7
unnamed: R52.1, U12.CN7_28 (PA0)
unnamed: R51.1, U12.CN7_30 (PA1)
unnamed: R50.1, U12.CN7_32 (PA4)
unnamed: R49.1, U12.CN7_34 (PB0)
unnamed: R48.1, U12.CN7_38 (PC0)
unnamed: R47.1, U12.CN7_36 (PC1)
unnamed: R39.2, U12.CN10_23 (PA8)
unnamed: R46.2, U12.CN10_31 (PB3)
unnamed: R44.2, U12.CN10_27 (PB4)
unnamed: R45.2, U12.CN10_29 (PB5)
unnamed: R41.2, U12.CN10_25 (PB10)
unnamed: C46.2, R42.2, U13.3 (REF2), U13.7 (REF1)
VBUS: C1.1, C2.2, C8.2, C28.1, C29.1, C30.1, C31.1, C36.2, C37.1, C45.2, C47.1, C48.1, C49.2, D2.1 (K), D5.1 (K), JP2.3 (B), JP4.1 (A), U1.4 (EN), U1.5 (VIN), U2.1 (IN), U2.3 (EN), U9.5 (VM), U13.6 (V+)

Notes on the sheet:
JLC: C398355: TLV9062IDR
Photo Interruptor
VIN <=36V
dummy symbol to include motor mechanical step
12V -> 3.3V
we let JLC populate DRV8251A (lower rds_{ON}, and currently cheaper) DRV8231ADDA: C5218849 DRV8251ADDA: C5218844
Motor Connector pins mapped to allow TIM2 to be configured in CubeMX as "combined channels" in Encoder Mode to measure Motor Hall Encoder Signals as quadrature signals
USED A4 instead of B4 since in stock
ACHTUNG
(=MOTOR_DRV_IN1)
inverting config -> for Rthevenin << Rfeedback : hysteresis-width ~ independant from treshold center -> source impedance does not influence thresholds with 1.5V swing from photointerruptor we expect 3.3V (high) -> 1.8V (low) -> set center threshold to ~ 2.55V -> currently: switching threshold: 2.42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
PD configured in Software to request fixed 12V profile
TLV9152 is pin compatible with MCP6002 and TLV9062IDR supply with 5V or VBUS instead of 3V3 to avoid crossover distortion (and netter CMR). 5V instead of VBUS as default for compat. with TLV9062
No CTR given in Datasheet 1.) At IF = 20mA -> Datasheet guaratees > 0.5mA photocurrent -> estimated worst case CTR ~0.5/20 = 2.5% -> worst case IC @ 10mA LED drive = 240µA -> For Rload = 1k -> Vlow,out = 3.3-240µA*1k = 3.1V -> only 0.2V swing 2.) To guarantee saturation in worst case, Rload must li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
Schmitt-Trigger
(=ADC2_IN14)
alt.: SW_Omron_B3FS
internal PUs enabled on BUTTON1
5V for HALL-Supply and Back-EMF Measurement do NOT load more than ~30mA
(=ADC1_IN5)
MB1136: Nucleo64(F411)
CN7
µC internal PU
STM32G431CBT6
Display (optional)
shift down the 5V to 3V3
FIT0186 (measured with LAB supply @ 100% dutyc cycle WITHOUT gearbox) ~ 180mA @ no load and VM = 9V ~ 210mA @ no load and VM = 12V
(=HALL_B)
(=HALL_A)
Autor: Franz Patz
-> potentially change to switcher LMR51406YDBVR -> inductor alternatives: ASPI-4020S-100M-T(C3222037), SDCL1V4020-100M-R, 74405042100, XAL4040-103ME(C5144883) handsolder: SPM4020T-100M-LR, ANR4020T100M (C6808085)
Motor-Driver
(=ADC2_IN1)
Back-EMF measurement
internal PU(25k-55k)
INA241B4IDR: SOIC8 for easy soldering B4: 100V/V V+: 2.7V to 20V
PC13, 14, 15 cannot drive more than ~3mA (see DS)
USB Data onboard µC<->PC. USBC Power OPTIONAL NOT used for first experiments only If we want to power the Board with 9/12V via USBC-PD later (not sure if usbcpd negotiation hsa trouble with D2/D5)
Achtung: Für <>12V: C15850 statt C440198 C1, C29, C30, C37 da für 12V ok und günstiger
Potentiometer for manual speed control
more caps than necessary due to "bad" routing
HS91L02W2C01
General Purpose Timers: 2,3,4,5
CN10
USB2.0 7.2.4.1 and Upstream Facing Port Bypass Capacitance Table 7-7
Virtual GND for Back-EMF Measurement
this is a hack =)
(*1): not used since huge error for small currents -> therefore RIPROPI = 0Ohms to disabled internal current limit -> added external shunt resistor
long distance
VM: 4.5-V to 33-V supply rail f_{PWM}: 0 - 200kHz logic inputs: 100k internal PD IN1 = IN2 = 0 for t>1.5ms : low power mode IN1 = 1 && IN2 = 0 -> Forward IN1 = 1 && IN2 = 1 -> Slow decay IN1 = 0 && IN2 = 0 -> Fast decay Forward with coast (coast = async. fast decay) : IN1: 1 -> 0, IN2: always 0 For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
(=MOTOR_DRV_IN2)
(=ADC1_IN11)
(=ADC2_IN2)
JLC: TLV9152IDR: 1,16EUR TLV9062IDR: (C398355): 0.2EUR
Board Power Supply (+12V)
MATLAB
for mounting the display
(*1)
Advanced Control Timers: TIM1,8
reserved for VCP (Serial)
DC Motor Driver Board Elektronik & Technische Informatik HTL Graz-Gösting
Debug Header
MOTOR

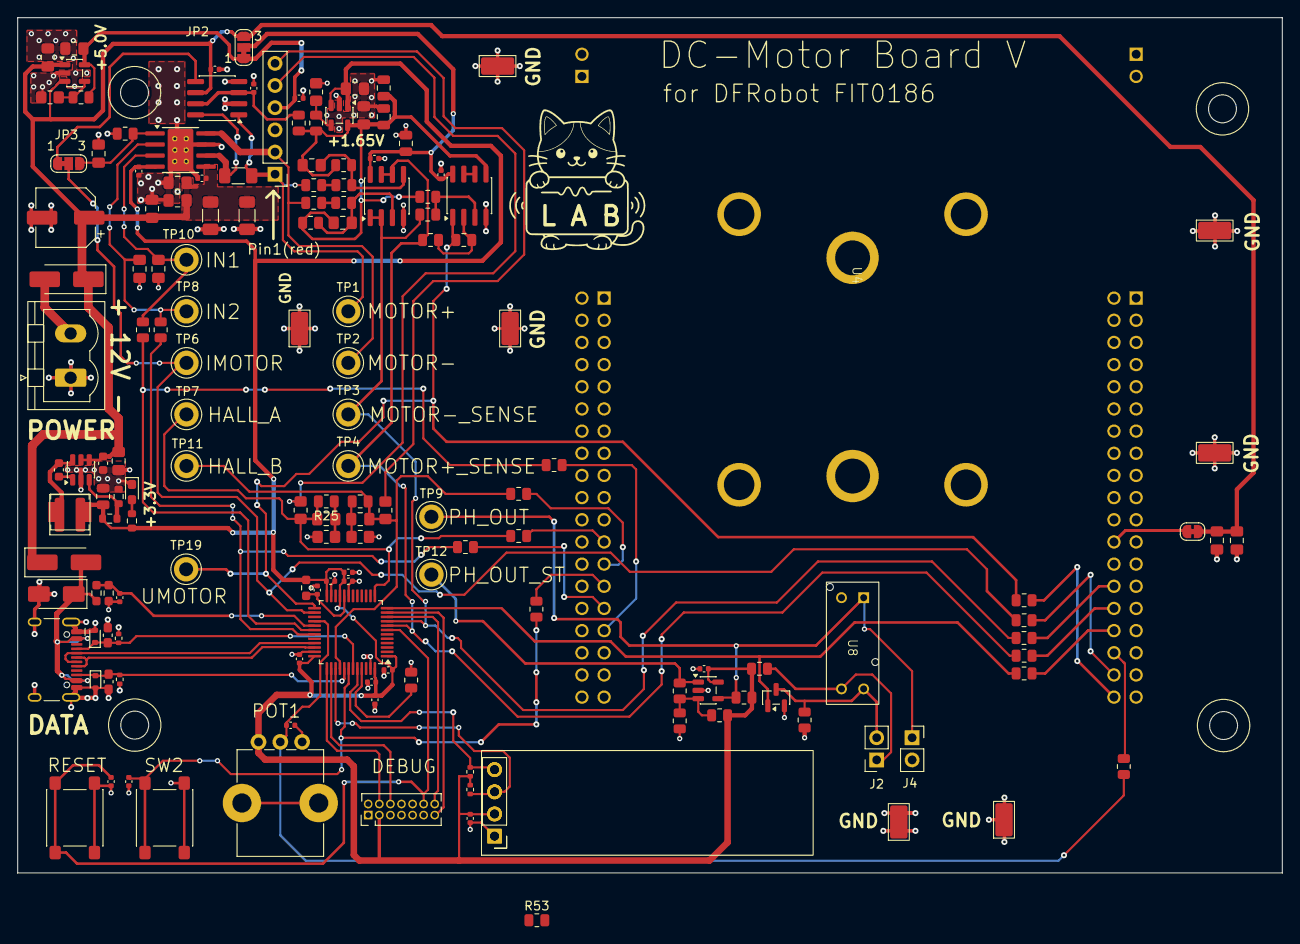
[picture p19: board dcMotor.kicad_pcb from above]

Board: 2 copper layers, 144.9 x 98.0 mm, 157 parts (1 on the bottom side), 75 nets.
