patzf/DC-Motor-Board/fw/pcb/fw.ioc

Mcu.UserName=STM32G431CBTx
PA0.Signal=ADC2_IN1
PA1.Signal=ADC2_IN2
PA11.Signal=USB_DM
PA12.Signal=USB_DP
PA13.Signal=SYS_JTMS-SWDIO
PA14.Signal=SYS_JTCK-SWCLK
PA15.Signal=I2C1_SCL
PA2.Signal=LPUART1_TX
PA3.Signal=LPUART1_RX
PA4.GPIO_Label=EN_PHOTO
PA4.Signal=GPIO_Output
PA5.Signal=S_TIM2_CH1
PA8.Signal=S_TIM1_CH1
PA9.Signal=S_TIM1_CH2
PB11.Signal=ADC2_IN14
PB12.Signal=ADC1_IN11
PB14.Signal=ADC1_IN5
PB15.Signal=ADC2_IN15
PB3.Signal=S_TIM2_CH2
PB4.Signal=UCPD1_CC2
PB5.GPIO_Label=BUTTON1
PB5.Signal=GPIO_Input
PB6.Signal=UCPD1_CC1
PB7.Signal=I2C1_SDA
PC14-OSC32_IN.GPIO_Label=VOUT_EN
PC14-OSC32_IN.Signal=GPIO_Output
