patzf/DC-Motor-Board/fw/pcb/Core/Inc/motor_control.h

/*
 * motor_control.h
 *
 *  Created on: 10 Oct 2026
 *      Author: franz
 */

#ifndef INC_MOTOR_CONTROL_H_
#define INC_MOTOR_CONTROL_H_


#include "tim.h"

extern void setMotorRPM(uint32_t rpm);

#endif /* INC_MOTOR_CONTROL_H_ */
