patzf/DC-Motor-Board/fw/pcb/Core/Inc/main.h

#define VOUT_EN_Pin GPIO_PIN_14
#define VOUT_EN_GPIO_Port GPIOC
#define EN_PHOTO_Pin GPIO_PIN_4
#define EN_PHOTO_GPIO_Port GPIOA
#define BUTTON1_Pin GPIO_PIN_5
#define BUTTON1_GPIO_Port GPIOB
