patzf/DC-Motor-Board/(commit log)

2026-07-14 initial local import
    [Transmotec-Cad-770.stp, dcMotor.kicad_pcb, dcMotor.kicad_sch]
2026-07-14 moved to G4
    [dcMotor.kicad_pcb, dcMotor.kicad_sch]
2026-07-15 redo PowerSupply designBlock
    [dcMotor.kicad_pcb, dcMotor.kicad_sch]
2026-07-15 Wip Photointerruptor
    [dcMotor.kicad_pcb, dcMotor.kicad_sch]
2026-07-19 added 3Dmodel to local prj
    [Motorhalterung_comp_v1.step, dcMotor.kicad_pcb, dcMotor.kicad_sch]
2026-07-20 relocated dummy cad model
    [dcMotor.kicad_pcb, dcMotor.kicad_sch]
2026-07-25 2nd usb for data only
    [dcMotor.kicad_sch]
2026-07-28 wip change to 48 pin package
    [dcMotor.kicad_pcb, dcMotor.kicad_sch]
2026-07-29 added PWM pin mapping of uC
    [dcMotor.kicad_pcb, dcMotor.kicad_sch]
2026-07-29 removed USBPDDB pins to have one I2C available
    [dcMotor.kicad_pcb]
2026-07-29 wip: some more pin remxing
    [dcMotor.kicad_pcb, dcMotor.kicad_sch]
2026-07-31 cleanup: removed higher pin uc variants from scheamatic
    [dcMotor.kicad_pcb, dcMotor.kicad_sch]
2026-07-31 added 5V hall sensor supply, some first positioning of components on board
    [dcMotor.kicad_pcb, dcMotor.kicad_sch]
2026-08-01 fix 3D model and footprint of photocoupler, calc resistors for Schmitt-Trigger
    [dcMotor.kicad_pcb, dcMotor.kicad_sch]
2026-08-01 added some docu, still unsre about back-emf measurement circuitry
    [dcMotor.kicad_pcb, dcMotor.kicad_sch]
2026-08-03 voltage dividers for measuring back-emf in coast mode
    [dcMotor.kicad_pcb, dcMotor.kicad_sch]
2026-08-03 replaced opamp
    [dcMotor.kicad_sch]
2026-08-03 back-emf sense wip
    [dcMotor.kicad_pcb, dcMotor.kicad_sch]
2026-08-04 change linear regulators
    [dcMotor.kicad_pcb, dcMotor.kicad_sch]
2026-08-04 forgot two caps. I am tired
    [dcMotor.kicad_sch]
2026-08-04 design blocks for linear regulators
    [dcMotor.kicad_pcb, dcMotor.kicad_sch]
2026-08-05 backup commit before reannotation
    [dcMotor.kicad_pcb, dcMotor.kicad_sch]
2026-08-06 finished prel routing
    [dcMotor.kicad_pcb, dcMotor.kicad_sch]
2026-08-06 prel design done
    [dcMotor.kicad_pcb, dcMotor.kicad_sch]
2026-08-06 added nucleo fpr MATLAB, still cutouts are missing
    [NUCLEO-L432KC.step, dcMotor.kicad_pcb, dcMotor.kicad_sch]
2026-08-11 correct footprint for motor fixture (added proper mechanical NPTH pads)
    [dcMotor.kicad_pcb, dcMotor.kicad_sch]
2026-08-11 added 3D model of motor fixture to git
    [Motorhalterung.FCStd]
2026-08-11 bug fixes in silkscreen
    [dcMotor.kicad_pcb]
2026-08-11 design cost optimisations
    [dcMotor.kicad_pcb, dcMotor.kicad_sch]
2026-08-11 revert last changes
    [dcMotor.kicad_pcb, dcMotor.kicad_sch]
2026-08-11 remove more parts to reduce costs
    [dcMotor.kicad_pcb, dcMotor.kicad_sch]
2026-08-13 PTH for mechanical holes
    [dcMotor.kicad_pcb]
2026-08-17 minor modifications
    [dcMotor.kicad_pcb]
2026-08-17 footprint for 64 pin nucleo on the bottom side
    [dcMotor.kicad_pcb, dcMotor.kicad_sch]
2026-08-28 changed opamp supply from 3V3 to 5V to avoid cross-over distortion
    [dcMotor.kicad_pcb, dcMotor.kicad_sch]
2026-08-28 changed to A2 and added docu
    [dcMotor.kicad_pcb, dcMotor.kicad_sch]
2026-08-28 remove 2nd USB connector
    [dcMotor.kicad_pcb, dcMotor.kicad_sch]
2026-08-29 applied 2nd USB connector removal to layout
    [dcMotor.kicad_pcb, dcMotor.kicad_sch]
2026-08-31 latest rev for review
    [dcMotor.kicad_pcb, dcMotor.kicad_sch]
2026-08-31 connect nucleo
    [dcMotor.kicad_pcb, dcMotor.kicad_sch]
2026-09-01 finished layout
    [dcMotor.kicad_pcb]
2026-09-02 added diffamp just for experimenting
    [dcMotor.kicad_pcb, dcMotor.kicad_sch]
2026-09-02 ioc cube file for 32pin nucleo fpr quick PWM test
    [dcMotor.kicad_pcb, dcMotor.kicad_sch]
2026-09-02 added filter caps on pwm inputs because of DRV8321 errata (glitches)
    [dcMotor.kicad_pcb, dcMotor.kicad_sch]
2026-09-03 wip. that is a fuc** dumb motor driver IC. thanks for nothing, TI
    [dcMotor.kicad_pcb, dcMotor.kicad_sch]
2026-09-03 schematic before adding shunt current measurement because DRV8231A inbuilt current sense is so bad
    [dcMotor.kicad_sch]
2026-09-03 added shunt measurement for current
    [dcMotor.kicad_pcb, dcMotor.kicad_sch]
2026-09-05 added experimental pwm code
2026-09-05 apply gitignore
    [NUCLEO-L432KC.step]
2026-09-06 rearranged schematic to fit page
    [dcMotor.kicad_pcb, dcMotor.kicad_sch]
2026-09-07 updated ioc for PCB
2026-09-07 have to change pins towards Nucleo and add jumpers
    [dcMotor.kicad_pcb, dcMotor.kicad_sch]
2026-09-08 nucleo supplied with VIN = 12V
    [dcMotor.kicad_pcb, dcMotor.kicad_sch]
2026-09-08 latest updates
    [dcMotor.kicad_pcb, dcMotor.kicad_sch]
2026-09-08 corrected rotation of U9, still bom makes seom troubles at JLC
    [dcMotor.kicad_pcb, dcMotor.kicad_sch]
2026-09-08 minor mods
    [dcMotor.kicad_pcb]
2026-09-09 minor corrections
    [dcMotor.kicad_pcb, dcMotor.kicad_sch]
2026-09-10 cleanup and pdf update
    [dcMotor.kicad_pcb, dcMotor.kicad_sch]
2026-09-19 some tests around USB DFU device class. wip
    [dcMotor.kicad_pcb]
2026-09-19 moved into hw subdir
    [Motorhalterung.FCStd, Motorhalterung_comp_v1.step, NUCLEO-L432KC.step, dcMotor.kicad_pcb, dcMotor.kicad_sch]
2026-09-20 prepared HW design for V1.1
    [Motorhalterung.FCStd, Motorhalterung_comp_v1.step, NUCLEO-L432KC.step, dcMotor.kicad_pcb, dcMotor.kicad_sch]
2026-09-22 some fixes in rigol python script
    [dcMotor.kicad_pcb]
2026-09-29 uC producing adc data
2026-10-03 fixed LPUART DMA bug
    [acquisition_controller.py, acquisition_worker.py, fw.ioc, main.c]
2026-10-04 USB CDC possible, but does not make sense - latest state before reverting to UART
