patzf/DC-Motor-Board/(notices)

Notices in the files:
fw/pcb/Core/Src/adc.c:
Copyright (c) 2026 STMicroelectronics.
All rights reserved.
This software is licensed under terms that can be found in the LICENSE file
fw/pcb/Core/Src/shell_pfs.c:
STM Shell is free software: you can redistribute it and/or modify it under the terms of the GNU General Public License
